Jophish/OS5000_Datalogger/schematics/Schematic.png

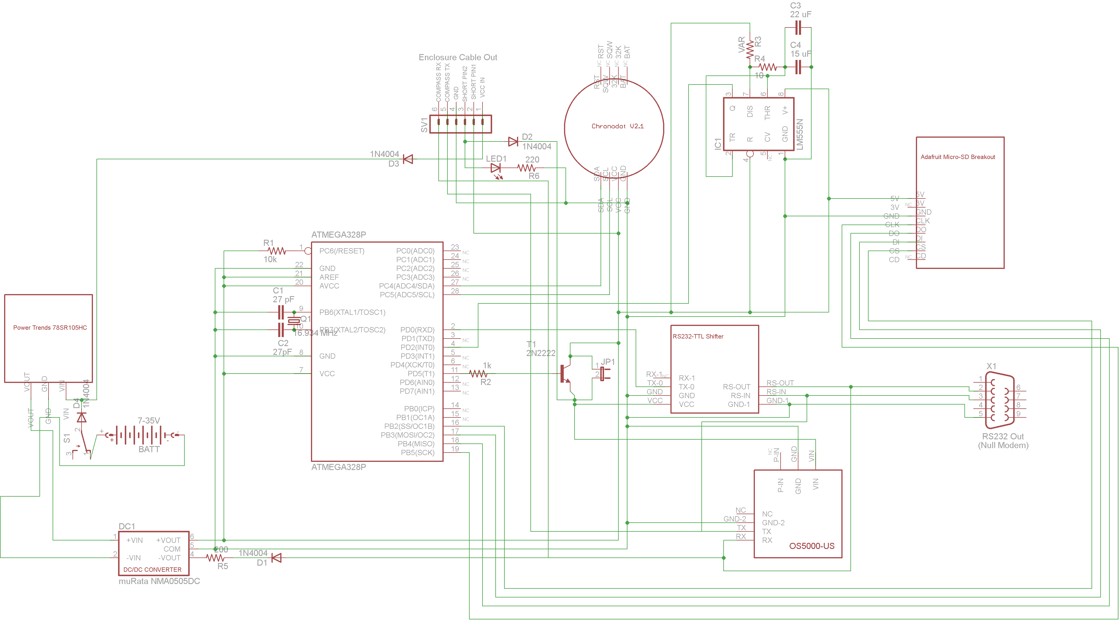
schematics/Schematic.png
