Jophish/OS5000_Datalogger/schematics/Schematic.sch

## EAGLE design schematics/Schematic.sch (2013-10-15)

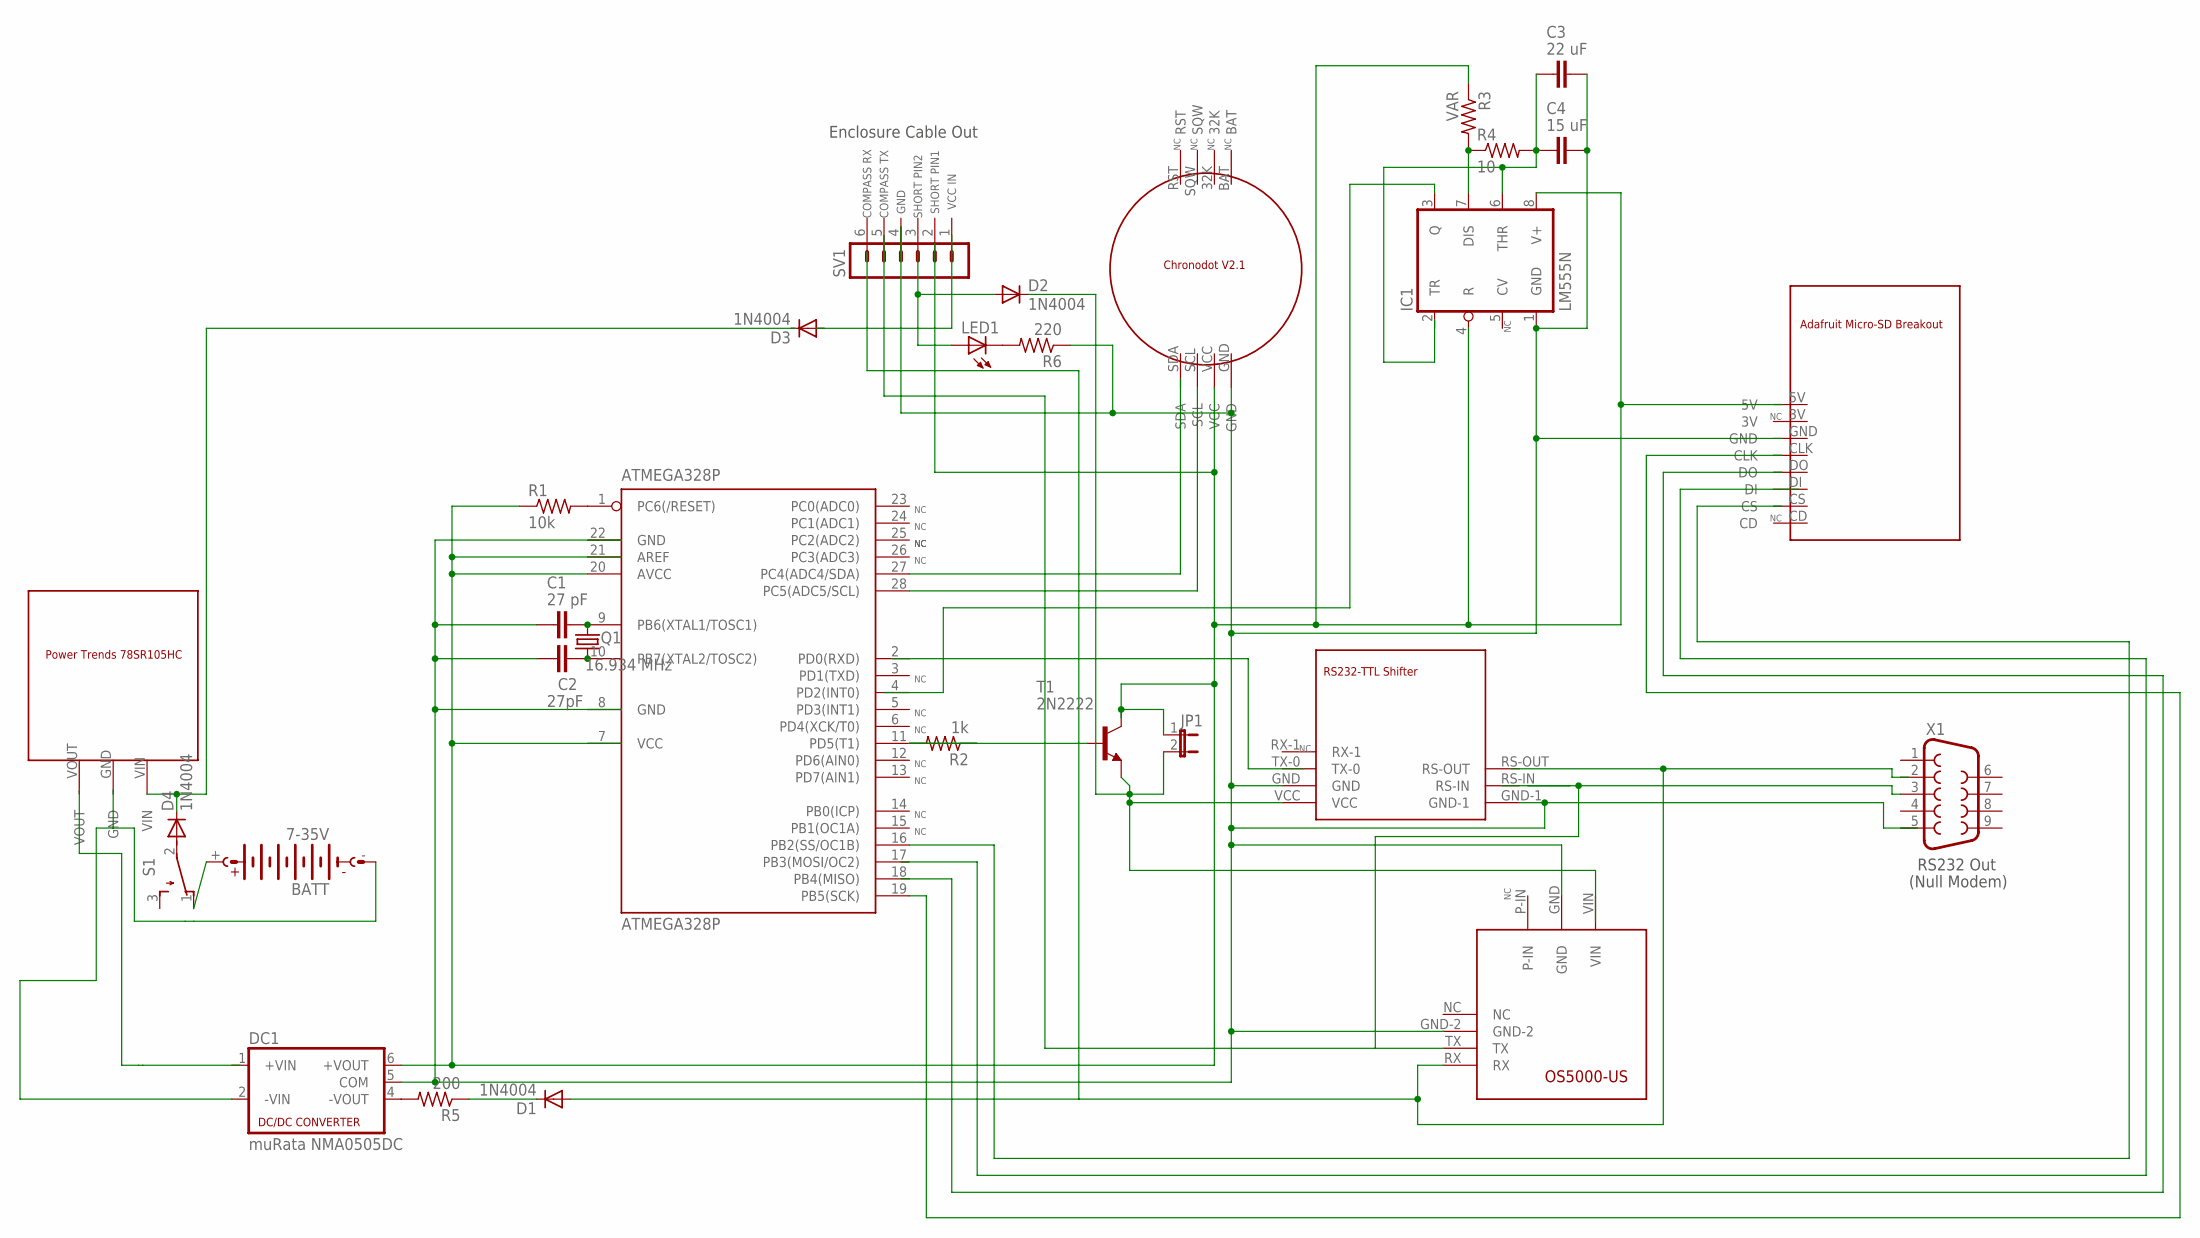
[picture p2: schematic Schematic.sch]

Parts:
ATMEGA328P: ATMEGA328P; DIL28-3
BATT: 7-35V; AB9V
C1: 27 pF; C2.5-3
C2: 27pF; C2.5-3
C3: 22 uF; C2.5-3
C4: 15 uF; C2.5-3
D1, D2, D3, D4: 1N4004; DO41-10
DC1: muRata NMA0505DC; NMA
IC1: LM555N; DIL08
JP1: JP1E; JP1
LED1: LAP4-BOTTOM; P47F-BOTTOM
Q1: 16.934 MHz; FC-12M
R1: 10k; 0204/5
R2: 1k; 0204/5
R3: VAR; 0204/5
R4: 10; 0204/5
R5: 200; 0204/5
R6: 220; 0204/5
S1: TL32PO; TL3XPO
SV1: MA06-1
T1: 2N2222; TO18
U$1: OS5000-US; RS232
U$2: CHRONODOT
U$3: ADAFRUIT-SD-BREAKOUT
U$4: RS232-TTL-SPARKFUN
U$5: POWER_TRENDS_78SR105HC
X1: F09D

Connections:
unnamed: ATMEGA328P.1 (PC6(/RESET)), R1.2
unnamed: DC1.6 (+VOUT), IC1.4 (R), IC1.8 (V+), JP1.1, R1.1, R3.1
unnamed: ATMEGA328P.9 (PB6(XTAL1/TOSC1)), C1.2, Q1.2
unnamed: ATMEGA328P.10 (PB7(XTAL2/TOSC2)), C2.2, Q1.1
unnamed: ATMEGA328P.11 (PD5(T1)), R2.1
unnamed: R2.2, T1.2 (B)
unnamed: D2.C, JP1.2, T1.1 (E), U$4.VCC
unnamed: IC1.7 (DIS), R3.2, R4.1
unnamed: U$1.TX, X1.3
unnamed: LED1.C, R6.2
unnamed: C3.1, C4.1, IC1.6 (THR), R4.2
unnamed: D1.A, U$1.RX
unnamed: DC1.4 (-VOUT), R5.2
unnamed: D1.C, R5.1
unnamed: C1.1, C2.1, C3.2, C4.2, DC1.5 (COM), IC1.1 (GND), R6.1, U$1.GND, U$1.GND-2, U$4.GND, U$4.GND-1
unnamed: D2.A, LED1.A
unnamed: BATT.-, DC1.2 (-VIN)
unnamed: BATT.+, S1.1 (O)

Notes on the sheet:
RS232 Out
(Null Modem)
Enclosure Cable Out
VCC IN
SHORT PIN1
SHORT PIN2
GND
COMPASS TX
COMPASS RX
