Jophish/OS5000_Datalogger/(commit log)

2013-10-15 Initial commit; source files, documentation, etc.
    [Schematic.sch]
2013-10-15 Clarified directory names
    [Schematic.sch]
2013-10-28 Broke up functions
    Cleaned a lot, made readable, added comments.
    [Data.ino, Datalogger.ino, LCD.ino, Power.ino, ReadWrite.ino, TimeDate.ino]
